chipmc/AirQualitySensorProject/README.md

AirQualitySensorProject
=======================

This is an Internet of Things Project to build an Air Quality sensor
