chipmc/AirQualitySensorProject/Air Quality Sensor Board BOM.xlsx

Sheet: Analysis
Summary | Qty1 | Qty100 | Qty1000
Physical | $7.39 | $5.08 | $4.23
Power | $8.17 | $7.47 | $7.47
Board/Connectors | $26.87 | $6.75 | $3.20
Passives | $3.44 | $1.71 | $1.45
Integrated Circuits | $4.76 | $3.05 | $2.86
Sensors | $24.85 | $16.01 | $15.18
 | $75.48 | $40.06 | $34.38

Sheet: BOM
 | Prices as of 11-19-14
Part | Value | Package | Description | Supplier | Part Number | Unit | Qty | Price | 100 Unit | 100 Price | 1000 Unit | 10000 Price | Physical | Power | Board/Conn | Passives | Ics | Sensors
ADS1015 | ADS1015 | SOP50P490X110-10N | ADC | Newark | 35R0211 | $3.150 | 1 | $3.15 | $2.310 | $2.31 | $2.31 | $2.31 |  |  |  |  | 1
Battery Connector | JST | JST-2-PTH | Standard 2-pin 0.1 header | Newark | 38K8066 | $0.106 | 1 | $0.11 | $0.106 | $0.11 | $0.076 | $0.08 |  |  | 1
C1 | .22uF | 0805 | Capacitor | Newark | 70K9140 | $0.117 | 1 | $0.12 | $0.032 | $0.03 | $0.027 | $0.03 |  |  |  | 1
C1X | 0.1uF | 0805 | Capacitor | Newark | 94W2909 | $0.035 | 2 | $0.07 | $0.035 | $0.07 | $0.035 | $0.07 |  |  |  | 1
C3 | 47uF - 2.92MOhm | 0805 | Capacitor | DigiKey | 445-8239-1-ND | $1.030 | 1 | $1.03 | $0.550 | $0.55 | $0.369 | $0.37 |  |  |  | 1
C4 | 2.2uF - 2.8Mohm | 1206 | Capacitor | DigiKey | 445-5207-1-ND | $0.790 | 1 | $0.79 | $0.365 | $0.36 | $0.247 | $0.25 |  |  |  | 1
D1 |  | SMA-DIODE | Diode | Newark | 09J8040 | $0.154 | 1 | $0.15 | $0.053 | $0.05 | $0.023 | $0.02 |  |  |  | 1
MOSFETs - Fan and Preheat | 2N7002P | SOT95P230X110-3N | MOSFET | Newark | 58K8769 | $0.218 | 2 | $0.44 | $0.061 | $0.12 | $0.041 | $0.08 |  |  |  |  | 1
FAN | 0.38W | 1.5" Square | DC Brushless Fan | DigiKey | 259-1574-ND | $7.390 | 1 | $7.39 | $5.080 | $5.08 | $4.230 | $4.23 | 1
HIH6131 | HIH6131 | SOIC8 | Honeywell Tem/Humid Sensor w/ Filter | Digikey | 480-3652-1-ND | $15.130 | 1 | $15.13 | $9.807 | $9.81 | $8.976 | $8.98 |  |  |  |  |  | 1
Male Headers | 0.1 Spacing | 0.1" spacing | Standard male headers - 40 pin stick | Amazon | Various | $0.200 | 1 | $0.20 | $0.100 | $0.10 | $0.050 | $0.05 |  |  | 1
L1 | 3.3uh - 0.026ohm | POWERINDUCTOR | 1.5A Tolerant Inductor | Digikey | SRR4028-3R3YCT-ND | $0.680 | 1 | $0.68 | $0.450 | $0.45 | $0.430 | $0.43 |  |  |  | 1
NC7SZU04 | INVERTER | SOT23-5 | Single inverter, SOT23-5 | Newark | 76C4059 | $0.360 | 1 | $0.36 | $0.130 | $0.13 | $0.100 | $0.10 |  |  |  |  | 1
PCA9306 | PCA9306 | SOIC8 | Bidirectional I2C level shifter. | Newark | 65J6232 | $0.816 | 1 | $0.82 | $0.484 | $0.48 | $0.366 | $0.37 |  |  |  |  | 1
R1 | 82 ohms | 0805 | Resistor | Newark | 94W6394 | $0.058 | 1 | $0.06 | $0.020 | $0.02 | $0.140 | $0.14 |  |  |  | 1
R1X | 1k | 0805 | Resistor | Newark | 05F1507 | $0.011 | 6 | $0.07 | $0.011 | $0.07 | $0.011 | $0.07 |  |  |  | 1
R2 | 100k ohms | 0805 | Resistor | Newark | 52K9808 | $0.096 | 1 | $0.10 | $0.024 | $0.02 | $0.017 | $0.02 |  |  |  | 1
R3 | 50 ohms | 0805 | Resistor | Newark | 89M6778 | $0.085 | 1 | $0.09 | $0.015 | $0.01 | $0.013 | $0.01 |  |  |  | 1
R3X | 200k | 0805 | Resistor | Newark | 49P0626 | $0.011 | 1 | $0.01 | $0.011 | $0.01 | $0.011 | $0.01 |  |  |  | 1
R4 | 51k ohms | 0805 | Resistor | Newark | 94W6311 | $0.002 | 1 | $0.002 | $0.002 | $0.002 | $0.002 | $0.002 |  |  |  | 1
R5 | 93.1 ohms | 0805 | Resistor | Newark | 53K0553 | $0.003 | 1 | $0.003 | $0.003 | $0.003 | $0.003 | $0.003 |  |  |  | 1
R6 | 82k ohms | 0805 | Resistor | Newark | 94W6394 | $0.058 | 1 | $0.06 | $0.020 | $0.02 | $0.014 | $0.01 |  |  |  | 1
R7 | 200 ohms | 0805 | Resistor | Newark | 58K4759 | $0.018 | 1 | $0.02 | $0.011 | $0.01 | $0.006 | $0.01 |  |  |  | 1
R9 | 150 ohms | 0805 | Resistor | DigiKey | 311-150CRCT-ND | $0.100 | 2 | $0.20 | $0.008 | $0.02 | $0.003 | $0.01 |  |  |  | 1
R12 | 820 ohm | 0805 | Resistor | Newark | 04P0646 | $0.002 | 2 | $0.004 | $0.002 | $0.004 | $0.002 | $0.004 |  |  |  | 1
TPS63002 | TPS63002DRCR | NEW-S-PVSON-N10 | Switching Buck-Boost 5V Converter | Newark | 19P7479 | $2.670 | 1 | $2.67 | $1.970 | $1.97 | $1.970 | $1.97 |  | 1
U$2 | MICS Socket | MICS-SMD-SOCKET | Socket for MICS Sensor | CDI Web | 620-10A-SM-G10-L14-1 | $12.000 | 1 | $12.00 | $6.000 | $6.00 | $3.000 | $3.00 |  |  | 1
MICS Sensor | MISC Sensor | SMD | MISC Sensor NO2 and CO | CDI Web | MICS-4514 | $9.720 | 1 | $9.72 | $6.200 | $6.20 | $6.200 | $6.20 |  |  |  |  |  | 1
Battery | 4.3V | Single Cell | 1000mAH LiPo Battery | Sparkfun | PRT-00339 | $5.500 | 1 | $5.50 | $5.500 | $5.50 | $5.500 | $5.50 |  | 1
Sencil | 1.1"x2.3" | 0.30mil | Polymide | OSHStencil | Air Quality Board 1.0 | $10.170 | 1 | $10.17 | $0.102 | $0.10 | $0.050 | $0.05 |  |  | 1
PCB | 2 Layer | ENIG | OSHPark Board | OshPark | NA | $4.390 | 1 | $4.39 | $0.439 | $0.44 | $0.022 | $0.02 |  |  | 1
Total BOM Cost |  |  |  |  |  |  |  | $75.48 |  | $40.06 |  | $34.38
 |  |  |  |  |  |  |  |  | Estimates
