chipmc/AirQualitySensorProject/Air Quality Board/Air Quality Board.brd

## EAGLE design Air Quality Board/Air Quality Board.brd (2014-11-21)

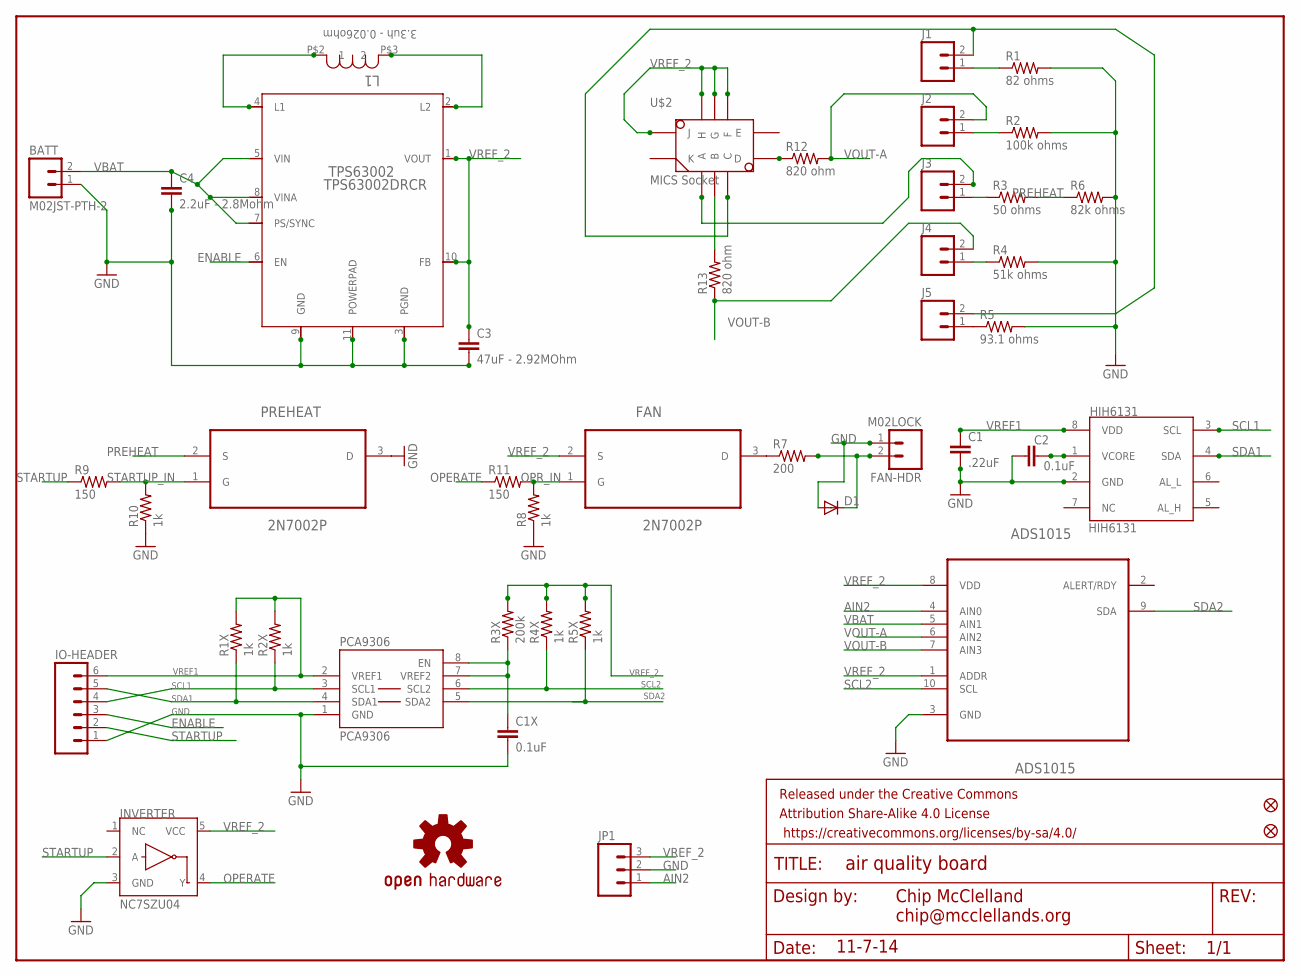
[picture p1: schematic Air Quality Board.sch]

Parts:
ADS1015: ADS1015; SOP50P490X110-10N
BATT: M02JST-PTH-2; JST-2-PTH
C1: .22uF; 0805
C1X, C2: 0.1uF; 0805
C3: 47uF - 2.92MOhm; 0805
C4: 2.2uF - 2.8Mohm; 1206
D1: DIODESMA; SMA-DIODE
FAN: 2N7002P; SOT95P230X110-3N
FAN-HDR: M02LOCK; 1X02_LOCK
FRAME1: FRAME-LETTER; CREATIVE_COMMONS
HIH6131: HIH6131; SOIC8
IO-HEADER: M06LOCK; 1X06_LOCK
J1, J2, J3, J4, J5: M02LOCK; 1X02_LOCK
JP1: M03LOCK; 1X03_LOCK
JP7, JP8: FIDUCIAL1X2.5; FIDUCIAL-1X2.5
L1: 3.3uh - 0.026ohm; POWERINDUCTOR
LOGO1: OSHW-LOGOS; OSHW-LOGO-S
NC7SZU04: INVERTER; SOT23-5
PCA9306: PCA9306; SOIC8
PREHEAT: 2N7002P; SOT95P230X110-3N
R1: 82 ohms; 0805
R1X, R2X, R4X, R5X, R8, R10: 1k; 0805
R2: 100k ohms; 0805
R3: 50 ohms; 0805
R3X: 200k; 0805
R4: 51k ohms; 0805
R5: 93.1 ohms; 0805
R6: 82k ohms; 0805
R7: 200; 0805
R9, R11: 150; 0805
R12, R13: 820 ohm; 0805
TPS63002: TPS63002DRCR; NEW-S-PVSON-N10
U$2: MICS Socket; MICS-SMD-SOCKET

Connections:
AIN2: ADS1015.4 (AIN0), JP1.1
ENABLE: IO-HEADER.3, TPS63002.6 (EN)
FAN: FAN.3 (D), R7.1
GND: ADS1015.3 (GND), BATT.1, C1.2, C1X.2, C2.1, C3.2, C4.2, D1.A, FAN-HDR.1, HIH6131.2 (GND), IO-HEADER.1, JP1.2, NC7SZU04.3 (GND), PCA9306.1 (GND), PREHEAT.3 (D), R1.2, R2.2, R4.2, R5.2, R6.2, R8.1, R10.1, TPS63002.3 (PGND), TPS63002.9 (GND), TPS63002.11 (POWERPAD)
J1: J1.2, J5.2, U$2.C
J3: J3.2, U$2.A
unnamed: J5.1, R5.1
unnamed: J4.1, R4.1
unnamed: J3.1, R3.1
unnamed: J2.1, R2.1
unnamed: J1.1, R1.1
unnamed: R13.2, U$2.B
unnamed: L1.P$2 (1), TPS63002.4 (L1)
unnamed: L1.P$3 (2), TPS63002.2 (L2)
unnamed: R12.1, U$2.D
unnamed: D1.C, FAN-HDR.2, R7.2
unnamed: C2.2, HIH6131.1 (VCORE)
OPERATE: NC7SZU04.4 (Y), R11.1
OPR_IN: FAN.1 (G), R8.2, R11.2
PREHEAT: PREHEAT.2 (S), R3.2, R6.1
SCL1: HIH6131.3 (SCL), IO-HEADER.4, PCA9306.3 (SCL1), R2X.1
SCL2: ADS1015.10 (SCL), PCA9306.6 (SCL2), R4X.1
SDA1: HIH6131.4 (SDA), IO-HEADER.5, PCA9306.4 (SDA1), R1X.1
SDA2: ADS1015.9 (SDA), PCA9306.5 (SDA2), R5X.1
STARTUP: IO-HEADER.2, NC7SZU04.2 (A), R9.1
STARTUP_IN: PREHEAT.1 (G), R9.2, R10.2
VBAT: ADS1015.5 (AIN1), BATT.2, C4.1, TPS63002.5 (VIN), TPS63002.7 (PS/SYNC), TPS63002.8 (VINA)
VOUT-A: ADS1015.6 (AIN2), J2.2, R12.2
VOUT-B: ADS1015.7 (AIN3), J4.2, R13.1
VREF1: C1.1, HIH6131.8 (VDD), IO-HEADER.6, PCA9306.2 (VREF1), R1X.2, R2X.2
VREF2: C1X.1, PCA9306.7 (VREF2), PCA9306.8 (EN), R3X.1
VREF_2: ADS1015.1 (ADDR), ADS1015.8 (VDD), C3.1, FAN.2 (S), JP1.3, NC7SZU04.5 (VCC), R3X.2, R4X.2, R5X.2, TPS63002.1 (VOUT), TPS63002.10 (FB), U$2.F, U$2.G, U$2.H, U$2.J

Notes on the sheet:
Chip McClelland chip@mcclellands.org
11-7-14

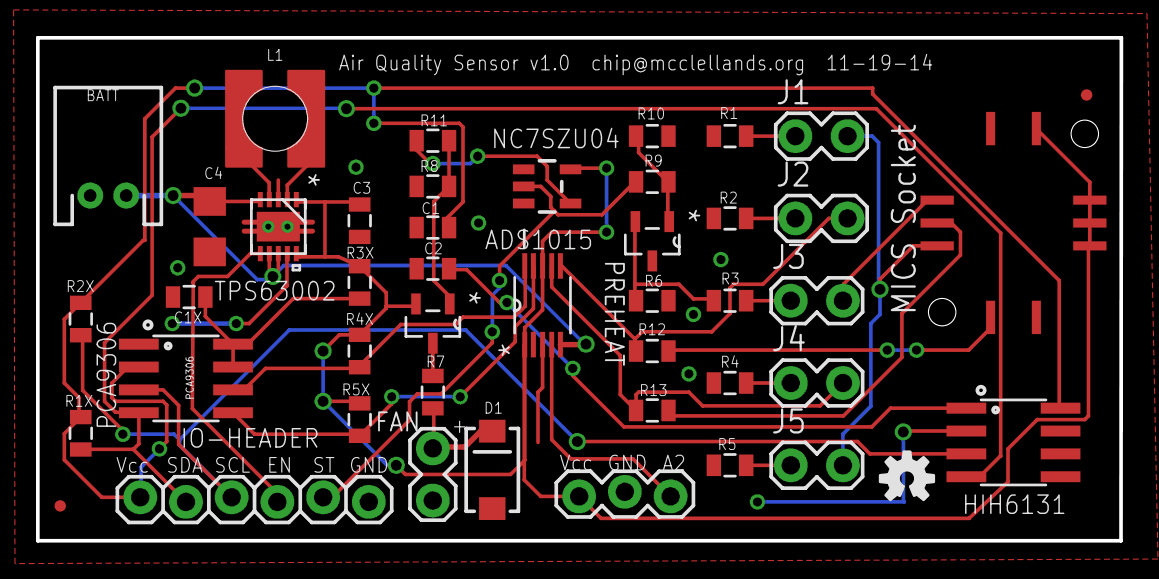
[picture p2: board Air Quality Board.brd from above]

Board: 2 copper layers, 60.2 x 27.9 mm, 46 parts (0 on the bottom side), 32 nets.
