chipmc/AirQualitySensorProject/(commit log)

2014-11-21 Added BOM Analysis Spreadsheet
    [Air Quality Sensor Board BOM.xlsx]
2014-11-21 Added the EAGLE Files
    [Air Quality Board.brd, Air Quality Board.sch]
2014-12-05 Added GPS Data to Ubidots reporting
    Just added GPS using the LinkIt ONE’s built in GPS
